mark-helwig/HCRL_Plato_Series_PCB/ARISTO_JUNCTION_BOARD.step

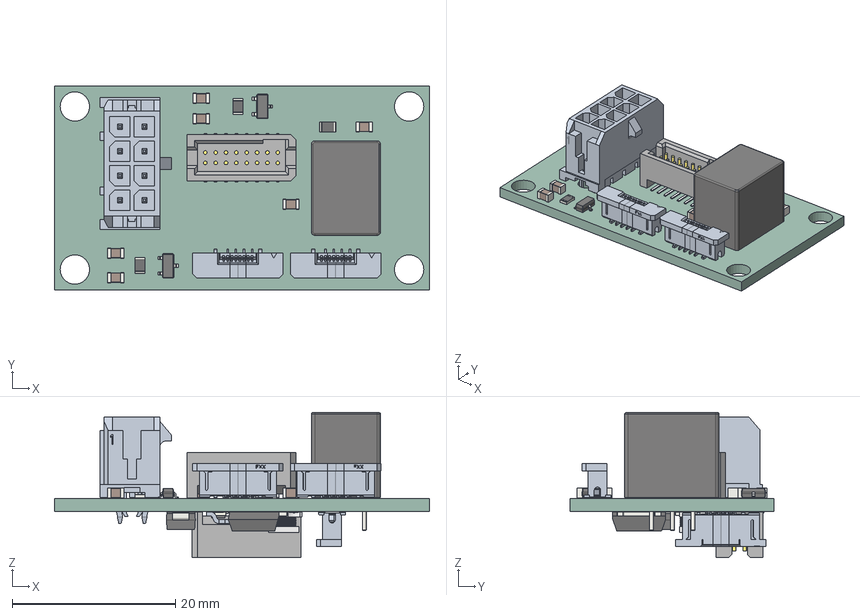
[picture p1: CAD file, 2025-11-03]
ARISTO_JUNCTION_BOARD.step
46.0 x 25.0 x 17.8 mm
C_0805_2012Metric x 6
SOT_23 x 2
Converter_DCDC_RECOM_R_78E_05_THT
F31W_31Z_8PIN_ASM x 3
R_0805_2012Metric x 4
TFM-108-02-L-D x 2
D_SOD_323F
RLS-397
D_SMB
CQ assembly
PLATO_JUNCTION_BOARD_PCB
