mark-helwig/HCRL_Plato_Series_PCB/imports/3587-20/3587-20.step

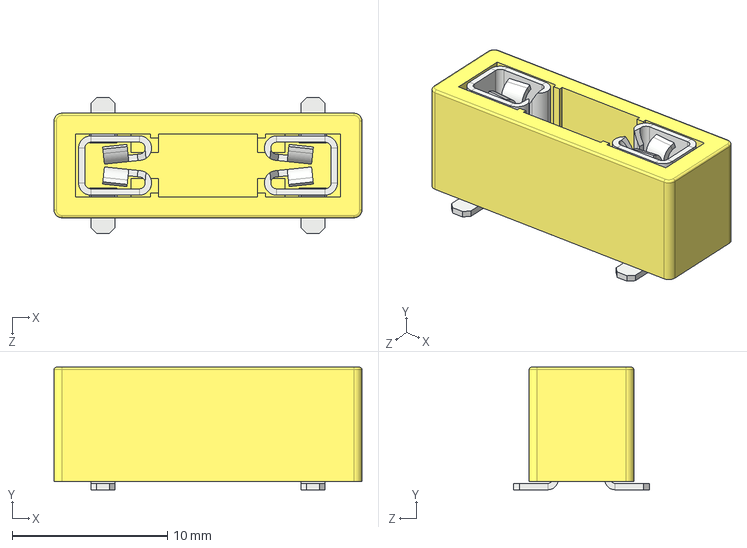
[picture p2: CAD file, 2025-10-23]
imports/3587-20/3587-20.step
19.8 x 7.88 x 8.76 mm
