mark-helwig/HCRL_Plato_Series_PCB/imports/DLW21SN900SQ2L/DLW21SN900SQ2L.step

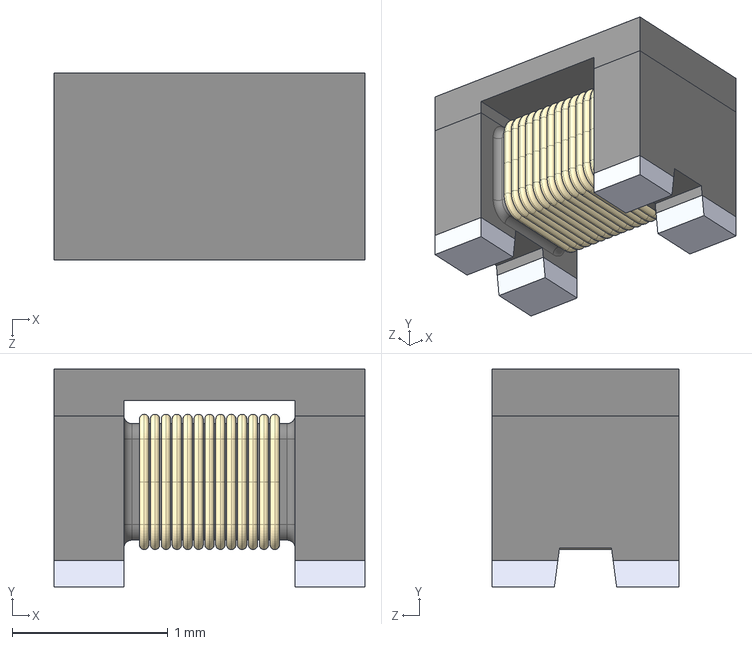
[picture p3: CAD file, 2025-10-23]
imports/DLW21SN900SQ2L/DLW21SN900SQ2L.step
2.00 x 1.40 x 1.20 mm
