mark-helwig/HCRL_Plato_Series_PCB/imports/F31W/F31W-1A7H1-11008.step

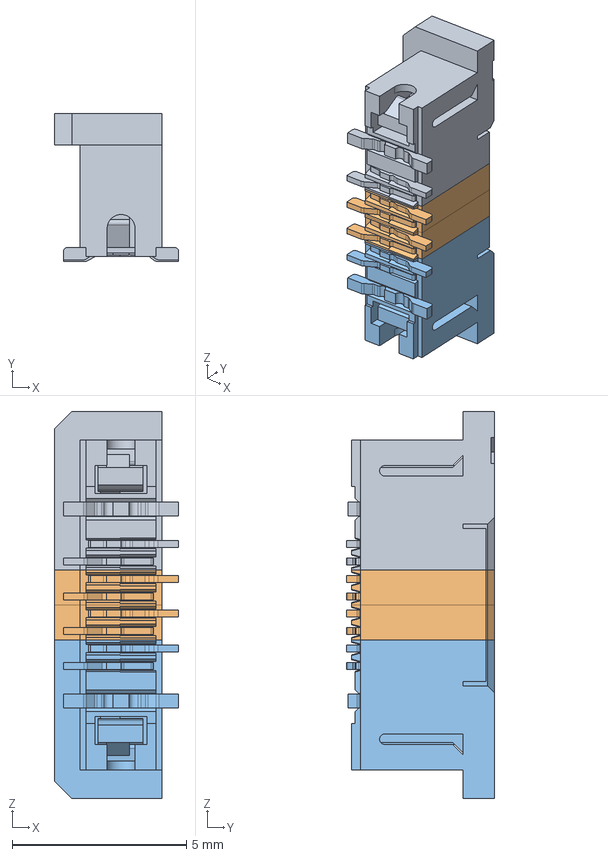
[picture p4: CAD file, 2025-10-23]
imports/F31W/F31W-1A7H1-11008.step
3.57 x 4.25 x 11.1 mm
F314_336_31W_31Z_L
F314_336_31W_31Z_M x 2
F314_336_31W_31Z_R_EVEN
