mark-helwig/HCRL_Plato_Series_PCB/imports/RLS-397/RLS-397.step

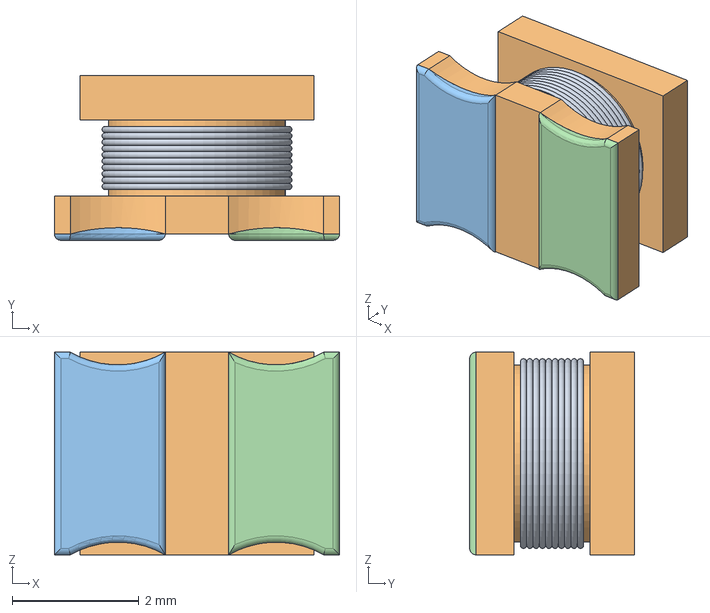
[picture p5: CAD file, 2025-10-23]
imports/RLS-397/RLS-397.step
4.50 x 2.60 x 3.20 mm
