mark-helwig/HCRL_Plato_Series_PCB/imports/TFM-108-02/TFM-108-02-L-D.stp

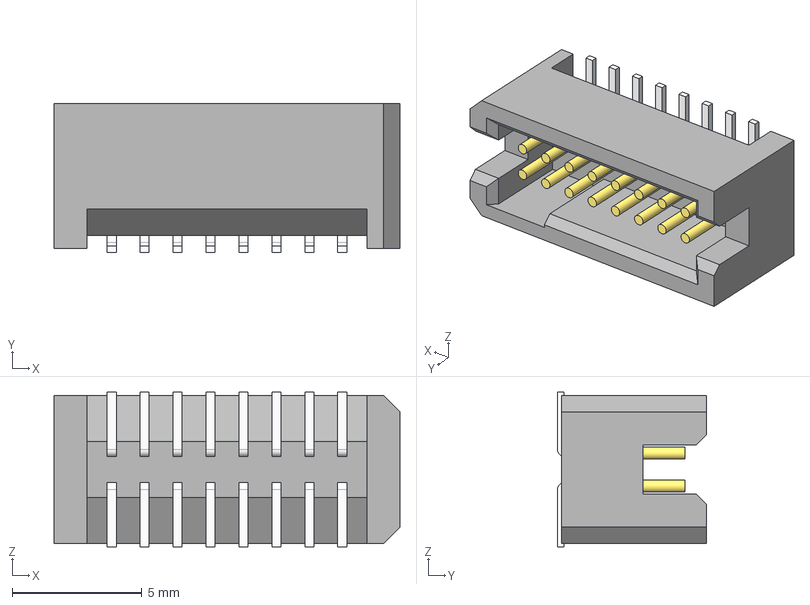
[picture p6: CAD file, 2025-10-23]
imports/TFM-108-02/TFM-108-02-L-D.stp
13.3 x 5.74 x 5.97 mm
TFM-108-02-L-D_terminal
TFM-108-02-L-D-L_pins
TFM-108-02-L-D-L-2_pins
