mark-helwig/HCRL_Plato_Series_PCB/imports/0430450825/0430450825.stp

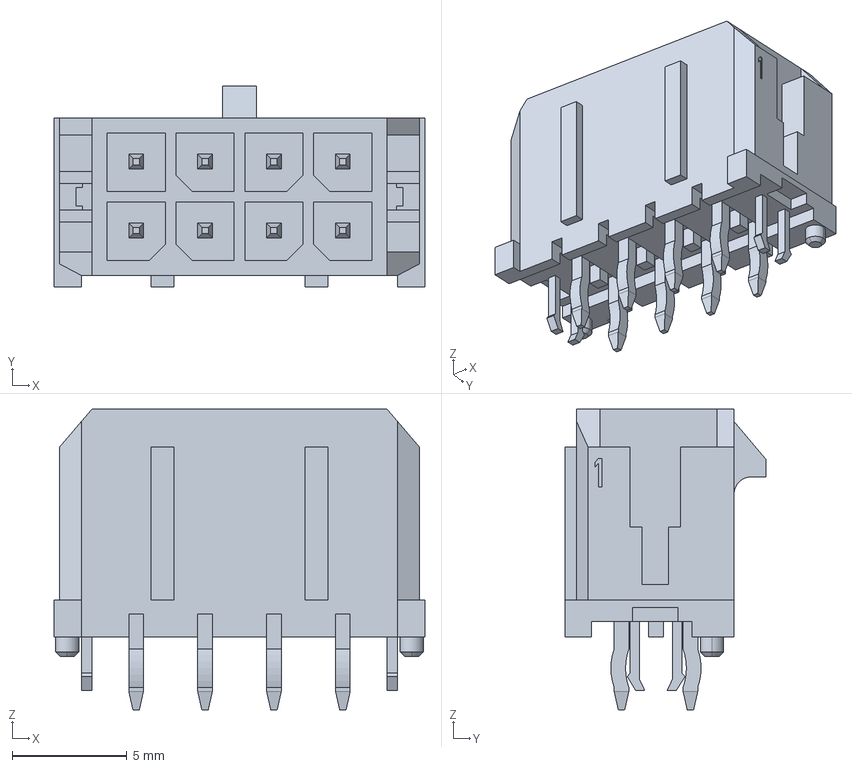
[picture p7: CAD file, 2025-10-24]
imports/0430450825/0430450825.stp
16.1 x 8.77 x 13.1 mm
