mark-helwig/HCRL_Plato_Series_PCB/imports/1053091104/1053091104.step

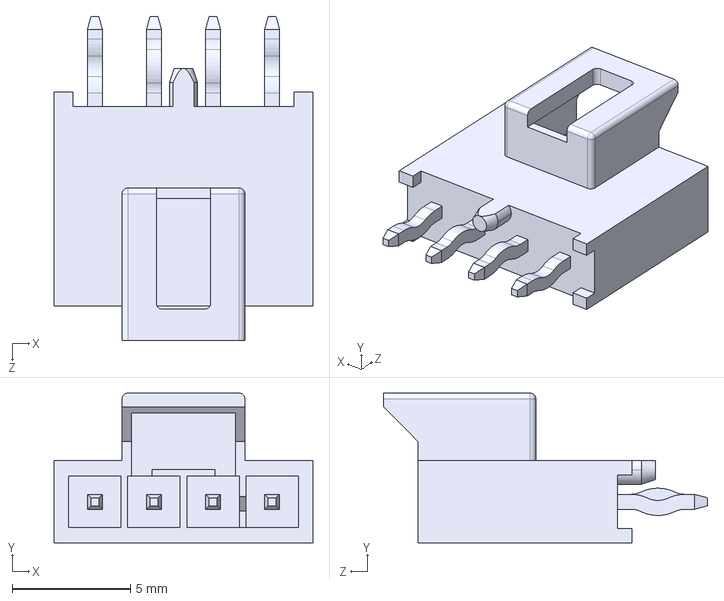
[picture p8: CAD file, 2025-10-23]
imports/1053091104/1053091104.step
10.9 x 6.34 x 13.7 mm
