mark-helwig/HCRL_Plato_Series_PCB/(commit log)

2025-10-23 Legacy board
    [1053091104.step, 3587-20.step, ARISTO_JUNCTION_BOARD.step, DLW21SN900SQ2L.step, F31W-1A7H1-11008.step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]
2025-10-24 Removed choke, added new connector
    [0430450825.stp, PLATO_JUNCTION_BOARD.kicad_pcb, PLATO_JUNCTION_BOARD.kicad_sch]
2025-10-24 initial layout of board complete
    [PLATO_JUNCTION_BOARD.kicad_pcb]
2025-10-24 Silkscreen and accreditation
    [PLATO_JUNCTION_BOARD.kicad_pcb]
2025-10-28 moved 24V and GND pins on J1, changed GND pads to square shapes
    [PLATO_JUNCTION_BOARD.kicad_pcb, PLATO_JUNCTION_BOARD.kicad_sch]
2025-10-29 adjusted CAN lines for EMI
    [PLATO_JUNCTION_BOARD.kicad_pcb]
2025-11-03 added oshpark drc
    [ARISTO_JUNCTION_BOARD.step, PLATO_JUNCTION_BOARD.kicad_pcb, PLATO_JUNCTION_BOARD.kicad_sch]
