mark-helwig/HCRL_Plato_Series_PCB/(notices)

Notices in the files:
imports/TFM-108-02/TFM-108-02-L-D.stp:
author */ ('License CC BY-ND 4.0'),
